matthew-hurst2004/MH24BN0001/MH24BN0001_hw/eda_downloads/61302021821_header/6130XX21821_61302021821.step

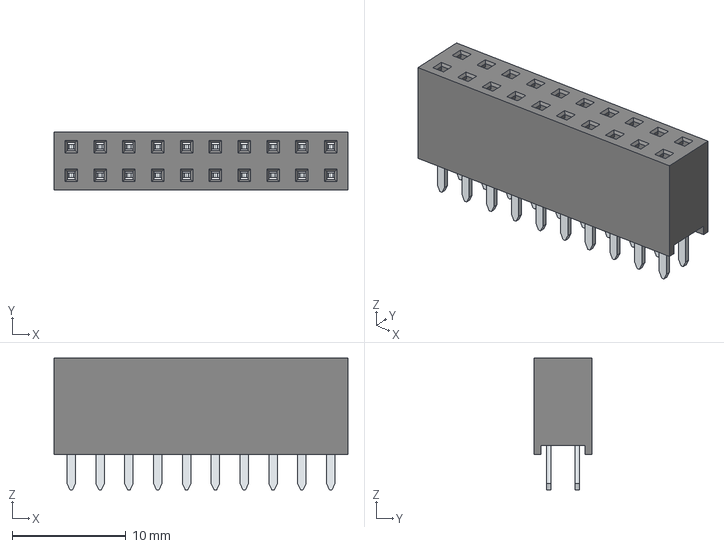
[picture p1: CAD file, 2024-11-20]
MH24BN0001_hw/eda_downloads/61302021821_header/6130XX21821_61302021821.step
25.9 x 5.08 x 11.6 mm
6130xx21821_PIN x 20
