matthew-hurst2004/MH24BN0001/MH24BN0001_hw/eda_downloads/STM32F401RBT6/STM32F401RBT6.step

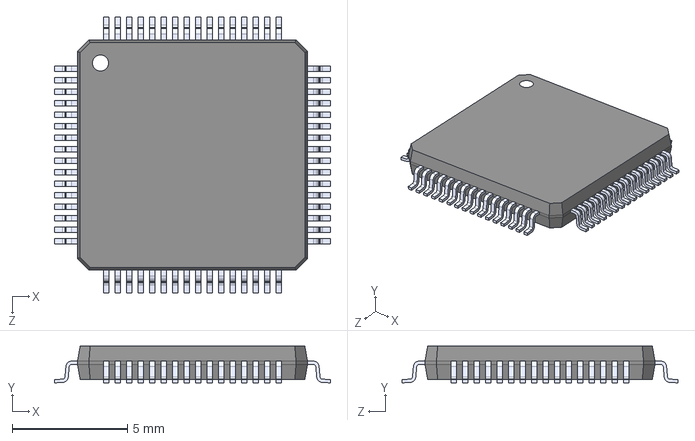
[picture p2: CAD file, 2024-11-21]
MH24BN0001_hw/eda_downloads/STM32F401RBT6/STM32F401RBT6.step
12.0 x 1.60 x 12.0 mm
