matthew-hurst2004/MH24BN0001/MH24BN0001_hw/MH24BN0001_hw.kicad_pcb

## KiCad design MH24BN0001_hw/MH24BN0001_hw.kicad_pcb (2024-11-25)

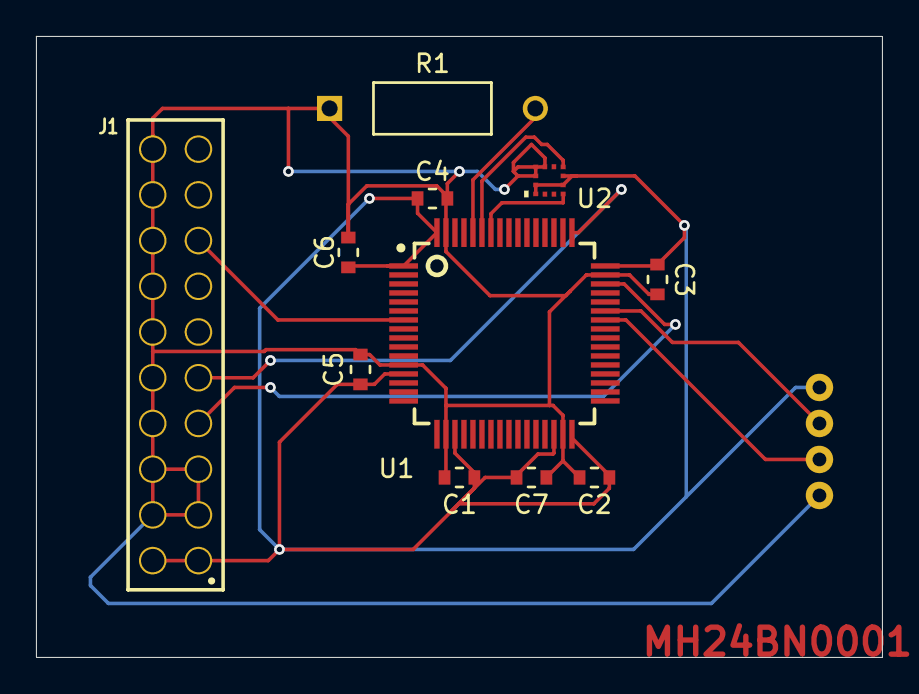
[picture p3: board MH24BN0001_hw.kicad_pcb from above]

Board: 2 copper layers, 47.0 x 34.5 mm, 12 parts (0 on the bottom side), 10 nets.

Parts:
C1, C2, C3, C4, C5, C6: 1µF; 1µF_cap
C7: 2.2µF; 2.2µF_cap
J1: ST-Link V2 Header; 61302021821
R1: 10 kΩ
SI1: serial_interface
U1: STM32F401RBT6; QFP50P1200X1200X160-64N
U2: Accelerometer; acc

Connections:
+3.3V: C1.1, C2.1, C3.1, C4.1, C5.1, C6.1, C7.1, J1.1, J1.2, SI1.1 (VCC), U1.1 (VBAT), U1.13 (VREF+), U1.19 (VDD), U1.30 (VCAP1), U1.32 (VDD__1), U1.48 (VDD__2), U1.64 (VDD__3), U2.2 (CS), U2.3 (SDO/SA0), U2.9 (VDD), U2.10 (VDDIO)
/MCU_RX: SI1.2 (TX), U1.43 (PA10)
/MCU_TX: SI1.3 (RX), U1.42 (PA9)
/NRST: J1.15, U1.7 (NRST)
/SCL: U1.58 (PB6), U2.1 (SCL/SPC)
/SDA: U1.59 (PB7), U2.4 (SDA/SDI/SDO)
/SWCLK: J1.9, U1.49 (PA14)
/SWDIO: J1.7, U1.46 (PA13)
GND: C1.2, C2.2, C3.2, C4.2, C5.2, C6.2, C7.2, J1.3, J1.4, J1.5, J1.6, J1.8, J1.10, J1.12, J1.14, J1.16, J1.18, J1.20, R1.1, SI1.4 (GND), U1.12 (VREF-), U1.18 (VSS), U1.31 (VSS__1), U1.47 (VSS__2), U1.63 (VSS__3), U2.6 (GND), U2.7 (RES), U2.8 (GND)
unnamed: R1.2, U1.60 (BOOT0)
