matthew-hurst2004/MH24BN0001/(commit log)

2024-11-20 Adding sub-directory for hardware files
    [MH24BN0001.kicad_pcb, MH24BN0001.kicad_sch]
2024-11-20 Removing all files
    [MH24BN0001.kicad_pcb, MH24BN0001.kicad_sch]
2024-11-20 Removing files again
    [MH24BN0001.kicad_pcb, MH24BN0001.kicad_sch]
2024-11-20 Adding final sub-directory for hardware files
    [MH24BN0001_hw.kicad_pcb, MH24BN0001_hw.kicad_sch]
2024-11-20 Adding footprint and symbol libraries, creating symbol for STM32, importing footprint for header, placing header and doing simple wiring, placing STM32 with no wiring
    [6130XX21821_61302021821.step, MH24BN0001_hw.kicad_pcb, MH24BN0001_hw.kicad_sch]
2024-11-20 previous commit
    [MH24BN0001_hw.kicad_sch]
2024-11-21 Changing chip to STM32F401RB
    [MH24BN0001_hw.kicad_sch, STM32F401RBT6.step]
2024-11-21 Adding essential pin functions to STM32F4
    [MH24BN0001_hw.kicad_sch]
2024-11-21 Adding SWDIO and SWCLK
    [MH24BN0001_hw.kicad_sch]
2024-11-21 Adding serial interface to board, finishing schematic
    [MH24BN0001_hw.kicad_pcb, MH24BN0001_hw.kicad_sch]
2024-11-22 starting PCB
    [MH24BN0001_hw.kicad_pcb, MH24BN0001_hw.kicad_sch]
2024-11-24 finishing pcb, generating output files
    [MH24BN0001_hw-B_Cu.gbl, MH24BN0001_hw-B_Mask.gbs, MH24BN0001_hw-B_Paste.gbp, MH24BN0001_hw-B_Silkscreen.gbo, MH24BN0001_hw-Edge_Cuts.gm1, MH24BN0001_hw-F_Cu.gtl, MH24BN0001_hw-F_Mask.gts, MH24BN0001_hw-F_Paste.gtp]
2024-11-24 Adding datasheet for STlink header
    [MH24BN0001_hw.kicad_sch]
2024-11-25 Generating new and final output files by which I ordered the PCB
    [MH24BN0001_hw-B_Cu.gbl, MH24BN0001_hw-B_Mask.gbs, MH24BN0001_hw-B_Paste.gbp, MH24BN0001_hw-B_Silkscreen.gbo, MH24BN0001_hw-Edge_Cuts.gm1, MH24BN0001_hw-F_Cu.gtl, MH24BN0001_hw-F_Mask.gts, MH24BN0001_hw-F_Paste.gtp]
